irvinehackerfab/spincoater/arduino/esp32_arduino/README.md

# ESP32
This folder contains [Arduino](https://www.arduino.cc/en/software/) programs that you flash onto the ESP32.

The guide for programming the ESP32 in the Arduino IDE can be found [here](https://docs.espressif.com/projects/arduino-esp32/en/latest/index.html).
