irvinehackerfab/spincoater/arduino/esp32_arduino/pwm/README.md

# ESP32 PWM
This program uses the [ESP32Servo](https://github.com/madhephaestus/ESP32Servo) library.
