irvinehackerfab/spincoater/rust/README.md

# Rust for Spin Coater
This is the workspace for device-agnostic libraries and [Rust](https://rust-lang.org/) programs that run on the host PC.

Programs that run on the spin coater's microcontrollers can be found in the [cross](./cross) folder.

To develop these programs, either [install Rust](https://rust-lang.org/tools/install/) or use the dev environment provided by and documented in [DEVELOPMENT.md](DEVELOPMENT.md).

To build `host_tui` for Windows, [install Nix](https://nixos.org/download/) and run `nix build .#host_tui_windows`. The `.exe` will be in `./result/bin/`.
