irvinehackerfab/spincoater/data/2026-10-09-controller-comparison/CMP_05_duty_cycle.png

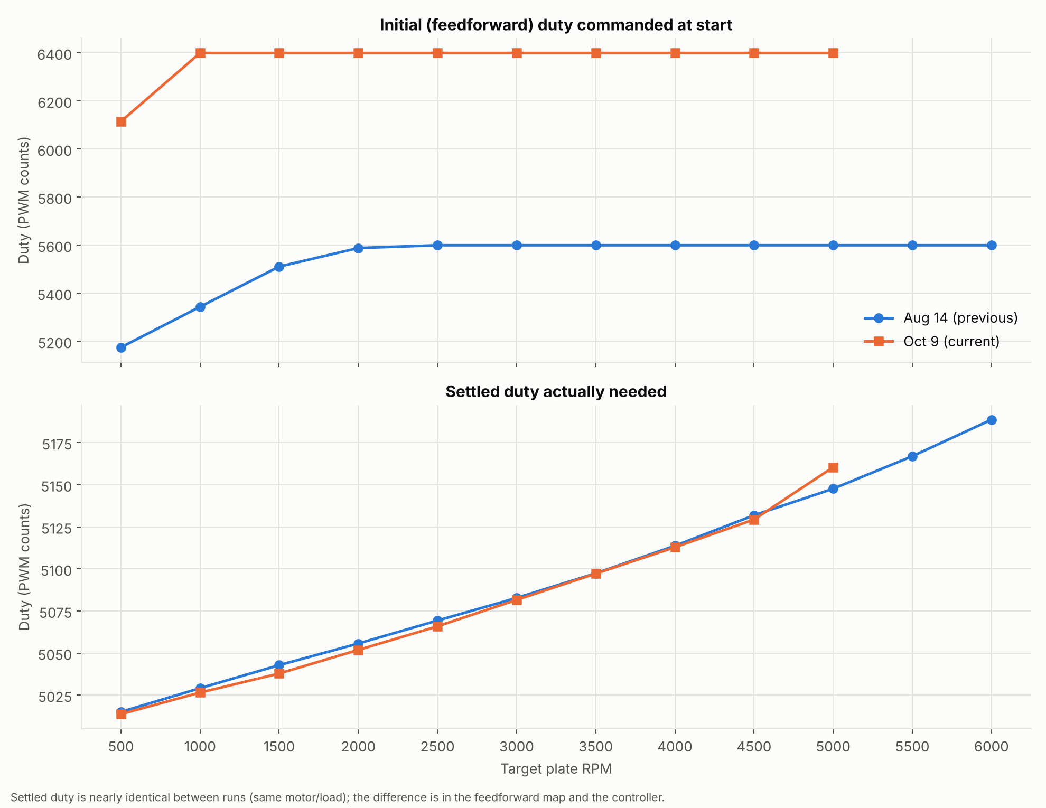
data/2026-10-09-controller-comparison/CMP_05_duty_cycle.png
