irvinehackerfab/spincoater/images/cad/v34-r1-section-closeup.png

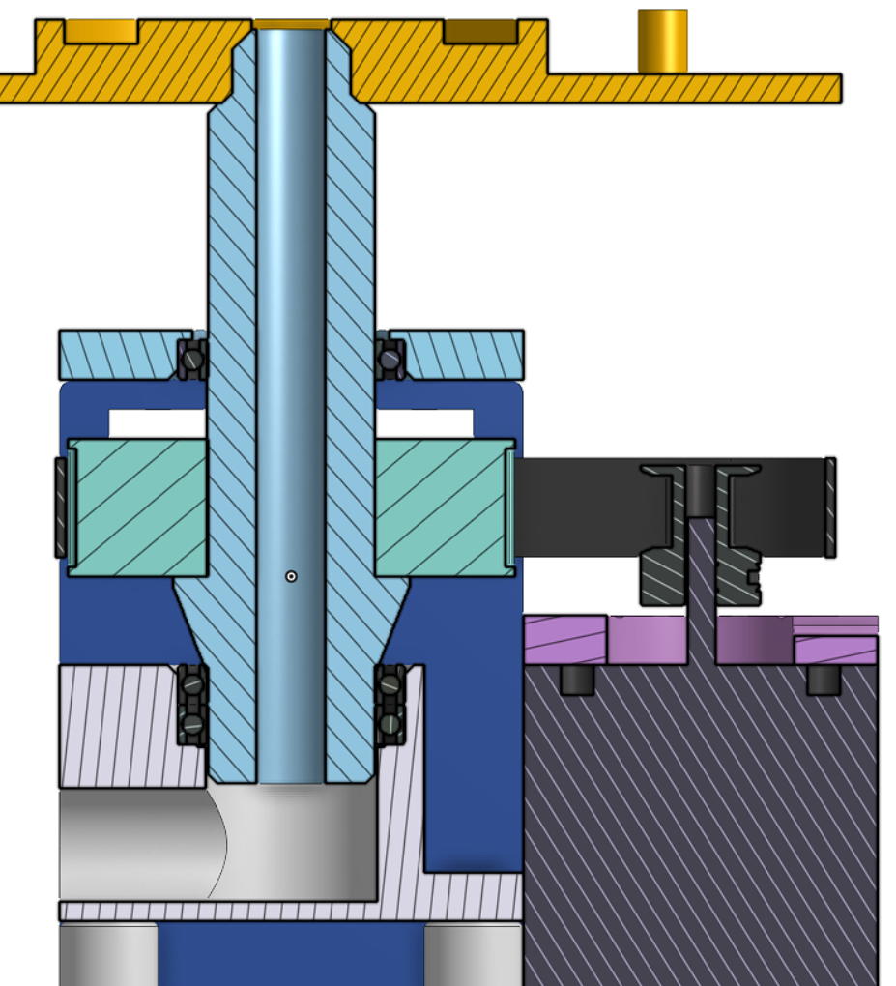
images/cad/v34-r1-section-closeup.png
