irvinehackerfab/spincoater/images/diagrams/power-board-schematic.png

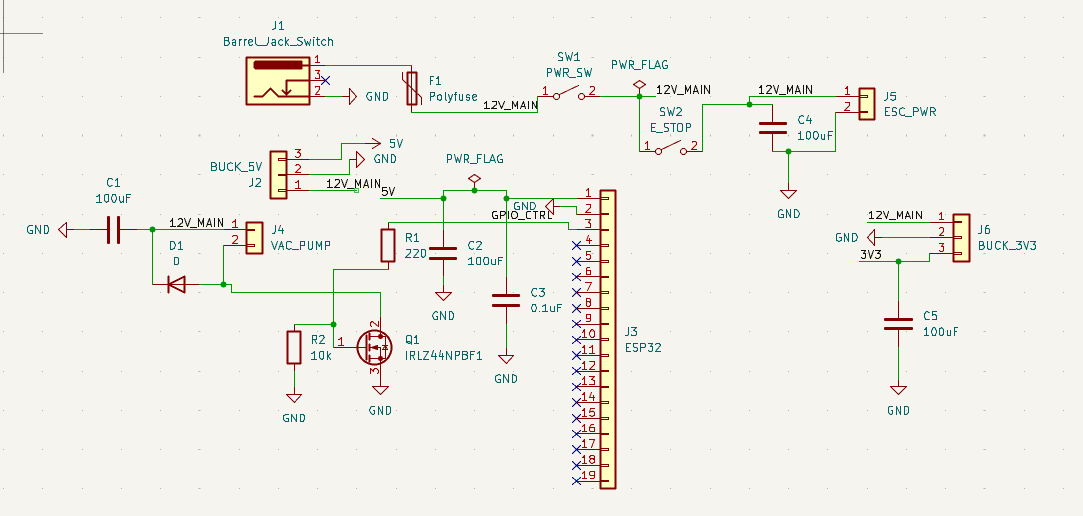
images/diagrams/power-board-schematic.png
