irvinehackerfab/spincoater/images/photos/2025-10-26-gt2-belts-and-pulley.jpg

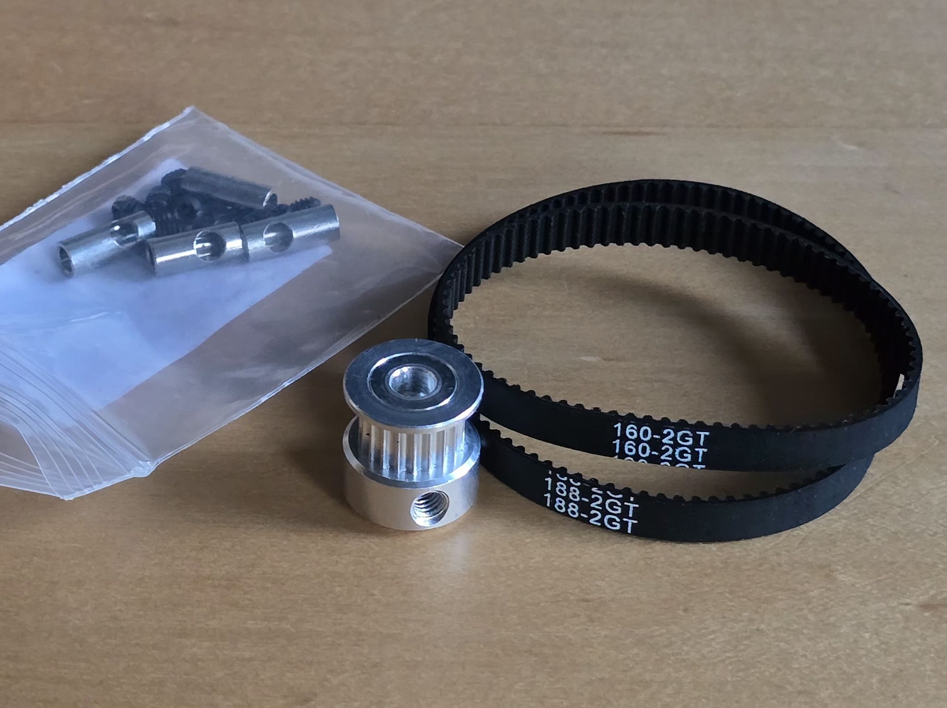
images/photos/2025-10-26-gt2-belts-and-pulley.jpg
