irvinehackerfab/spincoater/images/photos/2026-02-19-microscope-pattern-1.jpg

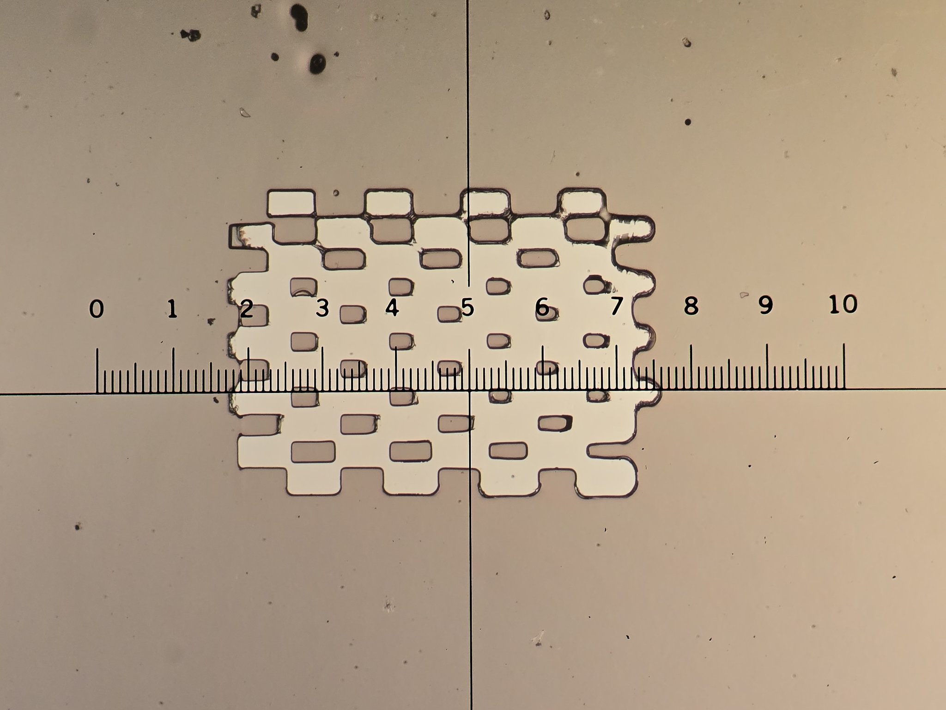
images/photos/2026-02-19-microscope-pattern-1.jpg
