irvinehackerfab/spincoater/images/photos/2026-05-07-screen-and-board-stack.jpg

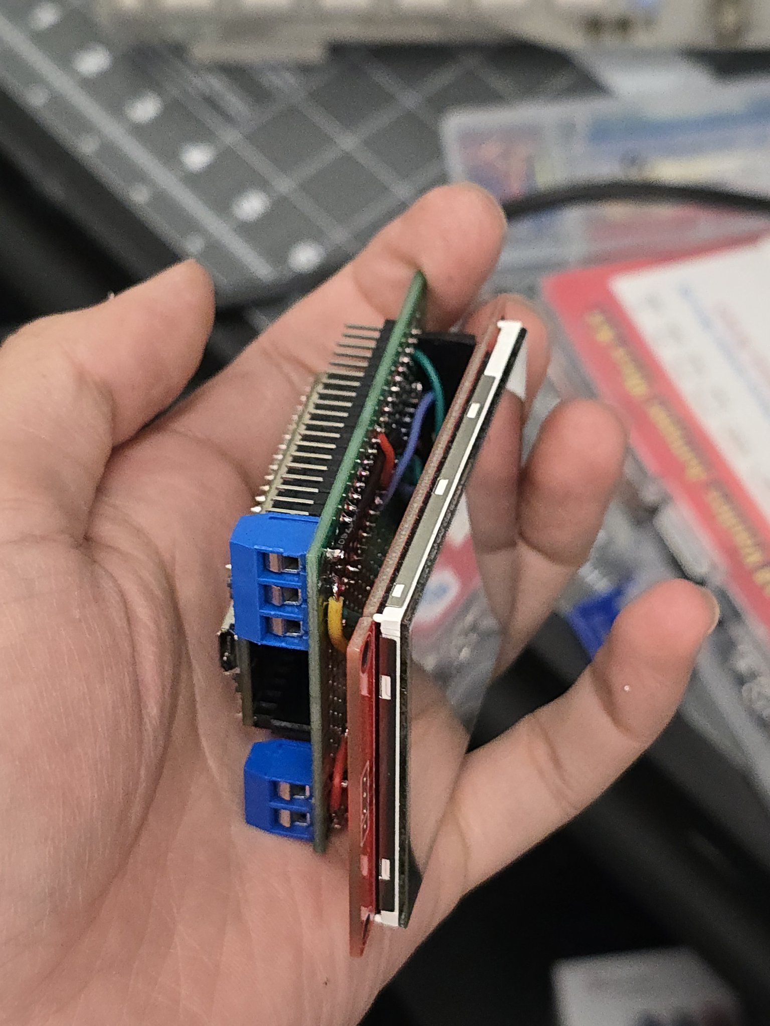
images/photos/2026-05-07-screen-and-board-stack.jpg
