irvinehackerfab/spincoater/hardware/cad/right-motor-mount-support.step

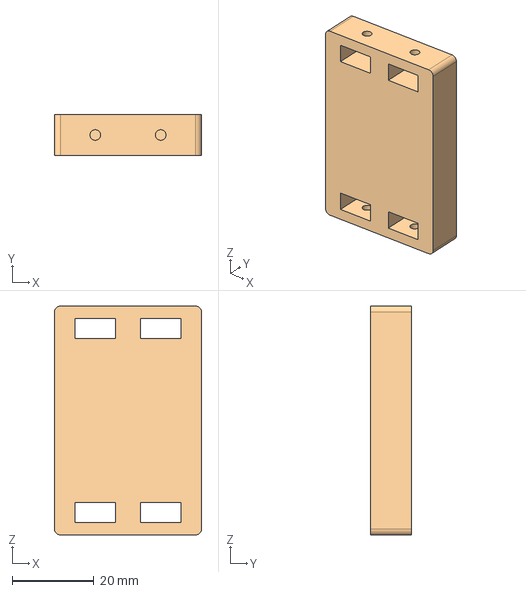
[picture p11: CAD file, 2026-10-12]
hardware/cad/right-motor-mount-support.step
36.0 x 10.0 x 56.0 mm
