irvinehackerfab/spincoater/hardware/cad/back-wall.step

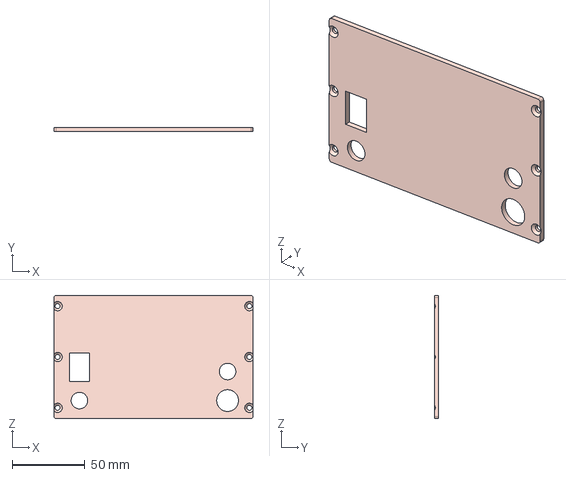
[picture p12: CAD file, 2026-10-12]
hardware/cad/back-wall.step
137.0 x 3.00 x 85.0 mm
