irvinehackerfab/spincoater/hardware/cad/right-wall.step

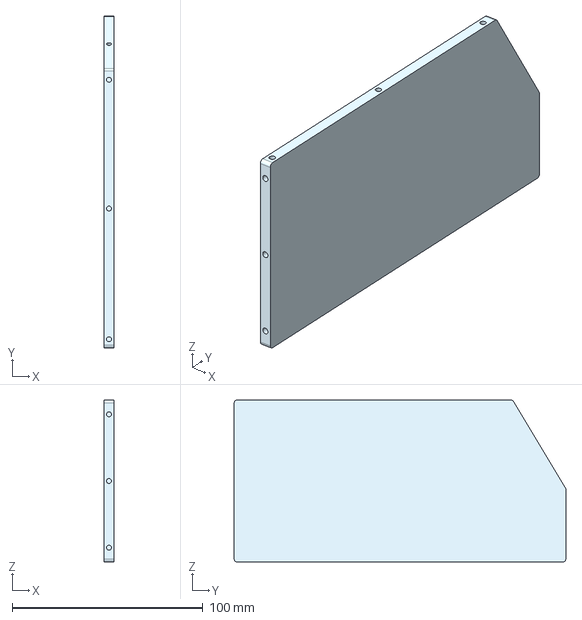
[picture p13: CAD file, 2026-10-12]
hardware/cad/right-wall.step
5.00 x 174.0 x 85.0 mm
