irvinehackerfab/spincoater/(list of files, cad)

Other CAD files:
hardware/cad/left-motor-mount-support.step
