irvinehackerfab/spincoater/data/2026-10-09-controller-comparison/CMP_02_step_response_grid.png

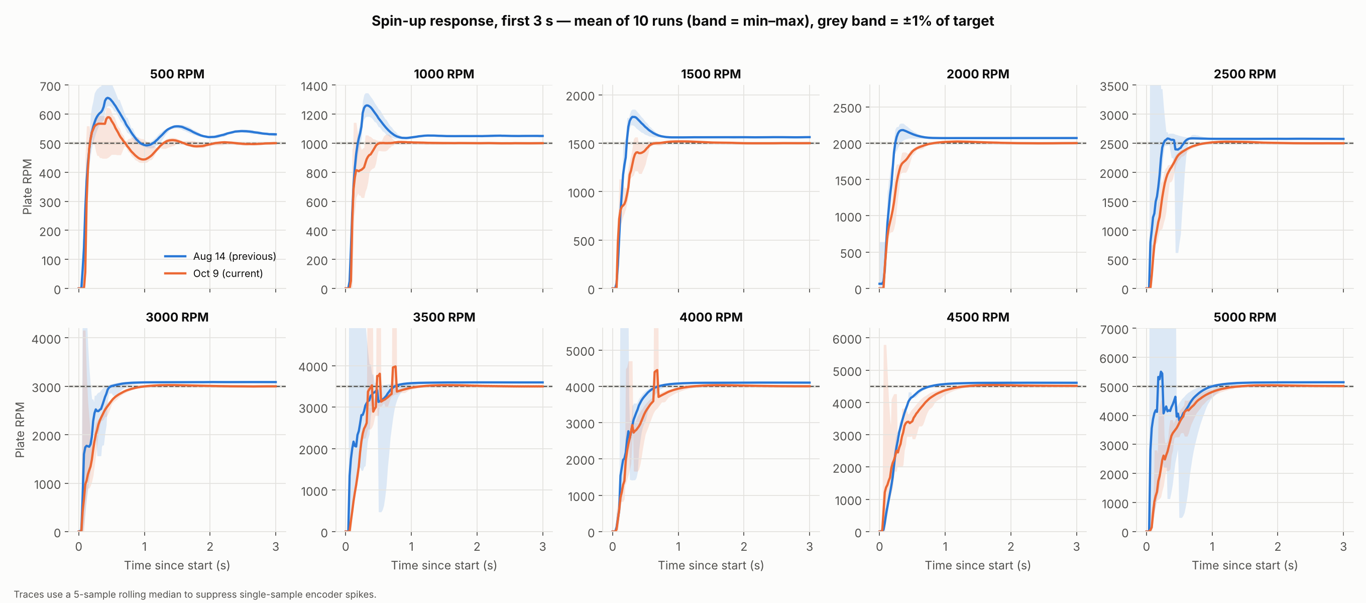
data/2026-10-09-controller-comparison/CMP_02_step_response_grid.png
