irvinehackerfab/spincoater/images/photos/2026-02-04-shaft-pulley-print.jpg

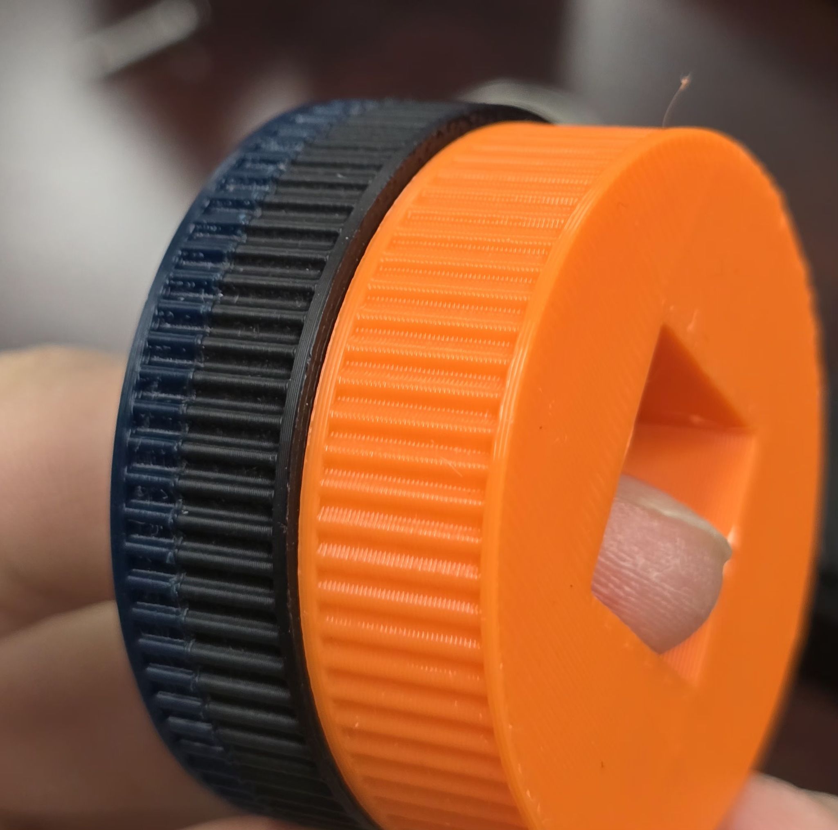
images/photos/2026-02-04-shaft-pulley-print.jpg
