irvinehackerfab/spincoater/images/photos/2026-05-08-wiring-side-panel-open.jpg

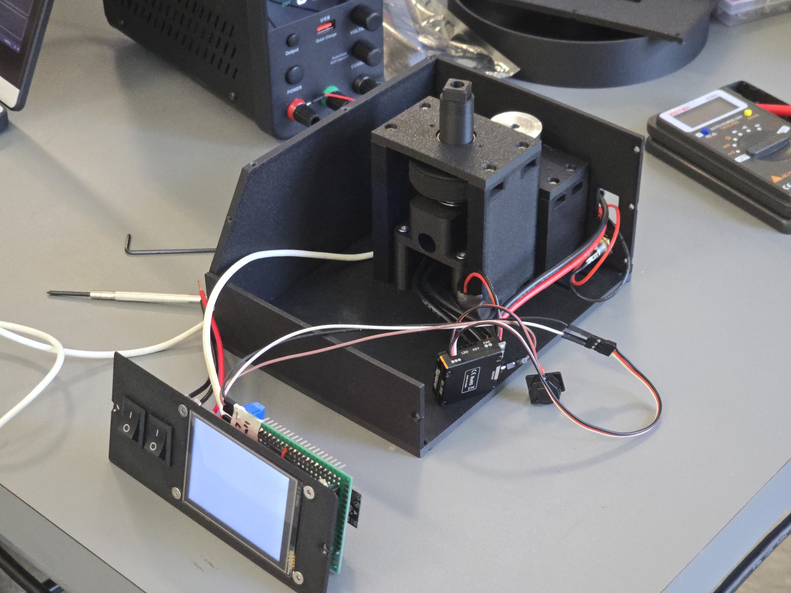
images/photos/2026-05-08-wiring-side-panel-open.jpg
