irvinehackerfab/spincoater/arduino/esp32_arduino/ESP32_spincoater_firmware/GUIv3_GSLC.h

//<File !Start!>
// FILE: [GUIv3_GSLC.h]
// Created by GUIslice Builder version: [0.17.b41]
//
// GUIslice Builder Generated GUI Framework File
//
// For the latest guides, updates and support view:
// https://github.com/ImpulseAdventure/GUIslice
//
//<File !End!>

#ifndef _GUISLICE_GEN_H
#define _GUISLICE_GEN_H

// ------------------------------------------------
// Headers to include
// ------------------------------------------------
#include "GUIslice.h"
#include "GUIslice_drv.h"

// Include any extended elements
//<Includes !Start!>
//<Includes !End!>

// ------------------------------------------------
// Headers and Defines for fonts
// Note that font files are located within the Adafruit-GFX library folder:
// ------------------------------------------------
//<Fonts !Start!>
#if !defined(DRV_DISP_TFT_ESPI)
  #error E_PROJECT_OPTIONS tab->Graphics Library should be Adafruit_GFX
#endif
#include <TFT_eSPI.h>
#include "dosis_book8pt7b.h"
//<Fonts !End!>

// ------------------------------------------------
// Defines for resources
// ------------------------------------------------
//<Resources !Start!>
//<Resources !End!>

// ------------------------------------------------
// Enumerations for pages, elements, fonts, images
// ------------------------------------------------
//<Enum !Start!>
enum {E_PG_MAIN};
enum {E_ELEM_BOX1,E_ELEM_DURATIONDOWNBTN,E_ELEM_DURATIONUPBTN
      ,E_ELEM_RPMDOWN,E_ELEM_RPMUP,E_ELEM_STARTBTN,E_ELEM_TEXT3
      ,E_ELEM_TEXT4};
// Must use separate enum for fonts with MAX_FONT at end to use gslc_FontSet.
enum {E_DOSIS_BOOK8,MAX_FONT};
//<Enum !End!>

// ------------------------------------------------
// Instantiate the GUI
// ------------------------------------------------

// ------------------------------------------------
// Define the maximum number of elements and pages
// ------------------------------------------------
//<ElementDefines !Start!>
#define MAX_PAGE                1

#define MAX_ELEM_PG_MAIN 8 // # Elems total on page
#define MAX_ELEM_PG_MAIN_RAM MAX_ELEM_PG_MAIN // # Elems in RAM
//<ElementDefines !End!>

// ------------------------------------------------
// Create element storage
// ------------------------------------------------
gslc_tsGui                      m_gui;
gslc_tsDriver                   m_drv;
gslc_tsFont                     m_asFont[MAX_FONT];
gslc_tsPage                     m_asPage[MAX_PAGE];

//<GUI_Extra_Elements !Start!>
gslc_tsElem                     m_asPage1Elem[MAX_ELEM_PG_MAIN_RAM];
gslc_tsElemRef                  m_asPage1ElemRef[MAX_ELEM_PG_MAIN];

#define MAX_STR                 100

//<GUI_Extra_Elements !End!>

// ------------------------------------------------
// Program Globals
// ------------------------------------------------

// Element References for direct access
//<Extern_References !Start!>
//<Extern_References !End!>

// Define debug message function
static int16_t DebugOut(char ch);

// ------------------------------------------------
// Callback Methods
// ------------------------------------------------
bool CbBtnCommon(void* pvGui,void *pvElemRef,gslc_teTouch eTouch,int16_t nX,int16_t nY);
bool CbCheckbox(void* pvGui, void* pvElemRef, int16_t nSelId, bool bState);
bool CbDrawScanner(void* pvGui,void* pvElemRef,gslc_teRedrawType eRedraw);
bool CbKeypad(void* pvGui, void *pvElemRef, int16_t nState, void* pvData);
bool CbListbox(void* pvGui, void* pvElemRef, int16_t nSelId);
bool CbSlidePos(void* pvGui,void* pvElemRef,int16_t nPos);
bool CbSpinner(void* pvGui, void *pvElemRef, int16_t nState, void* pvData);
bool CbTickScanner(void* pvGui,void* pvScope);

// ------------------------------------------------
// Create page elements
// ------------------------------------------------
void InitGUIslice_gen()
{
  gslc_tsElemRef* pElemRef = NULL;

  if (!gslc_Init(&m_gui,&m_drv,m_asPage,MAX_PAGE,m_asFont,MAX_FONT)) { return; }

  // ------------------------------------------------
  // Load Fonts
  // ------------------------------------------------
//<Load_Fonts !Start!>
    if (!gslc_FontSet(&m_gui,E_DOSIS_BOOK8,GSLC_FONTREF_PTR,&dosis_book8pt7b,1)) { return; }
//<Load_Fonts !End!>

//<InitGUI !Start!>
  gslc_PageAdd(&m_gui,E_PG_MAIN,m_asPage1Elem,MAX_ELEM_PG_MAIN_RAM,m_asPage1ElemRef,MAX_ELEM_PG_MAIN);

  // NOTE: The current page defaults to the first page added. Here we explicitly
  //       ensure that the main page is the correct page no matter the add order.
  gslc_SetPageCur(&m_gui,E_PG_MAIN);
  
  // Set Background to a flat color
  gslc_SetBkgndColor(&m_gui,GSLC_COL_BLACK);

  // -----------------------------------
  // PAGE: E_PG_MAIN
  
  
  // create E_ELEM_STARTBTN button with text label
  pElemRef = gslc_ElemCreateBtnTxt(&m_gui,E_ELEM_STARTBTN,E_PG_MAIN,
    (gslc_tsRect){10,10,100,100},(char*)"START",0,E_DOSIS_BOOK8,&CbBtnCommon);
  gslc_ElemSetTxtCol(&m_gui,pElemRef,GSLC_COL_BLACK);
  gslc_ElemSetCol(&m_gui,pElemRef,((gslc_tsColor){0,255,128}),((gslc_tsColor){0,255,128}),GSLC_COL_GREEN);
  gslc_ElemSetRoundEn(&m_gui, pElemRef, true);
  
  // create E_ELEM_RPMUP button with text label
  pElemRef = gslc_ElemCreateBtnTxt(&m_gui,E_ELEM_RPMUP,E_PG_MAIN,
    (gslc_tsRect){10,130,100,45},(char*)"RPM UP",0,E_DOSIS_BOOK8,&CbBtnCommon);
  gslc_ElemSetTxtCol(&m_gui,pElemRef,GSLC_COL_BLACK);
  gslc_ElemSetCol(&m_gui,pElemRef,GSLC_COL_YELLOW,GSLC_COL_YELLOW,GSLC_COL_ORANGE);
  gslc_ElemSetRoundEn(&m_gui, pElemRef, true);
  
  // create E_ELEM_DURATIONUPBTN button with text label
  pElemRef = gslc_ElemCreateBtnTxt(&m_gui,E_ELEM_DURATIONUPBTN,E_PG_MAIN,
    (gslc_tsRect){130,140,180,40},(char*)"DURATION UP",0,E_DOSIS_BOOK8,&CbBtnCommon);
  gslc_ElemSetRoundEn(&m_gui, pElemRef, true);
  
  // create E_ELEM_DURATIONDOWNBTN button with text label
  pElemRef = gslc_ElemCreateBtnTxt(&m_gui,E_ELEM_DURATIONDOWNBTN,E_PG_MAIN,
    (gslc_tsRect){130,190,180,40},(char*)"DURATION DOWN",0,E_DOSIS_BOOK8,&CbBtnCommon);
  gslc_ElemSetRoundEn(&m_gui, pElemRef, true);
   
  // Create E_ELEM_BOX1 box
  pElemRef = gslc_ElemCreateBox(&m_gui,E_ELEM_BOX1,E_PG_MAIN,(gslc_tsRect){130,10,180,120});
  gslc_ElemSetCol(&m_gui,pElemRef,GSLC_COL_GRAY,((gslc_tsColor){38,58,151}),((gslc_tsColor){38,58,151}));
  
  // Create E_ELEM_TEXT3 text label
  pElemRef = gslc_ElemCreateTxt(&m_gui,E_ELEM_TEXT3,E_PG_MAIN,(gslc_tsRect){159,28,120,12},
    (char*)"IRVINE HACKER FAB",0,E_DOSIS_BOOK8);
  gslc_ElemSetCol(&m_gui,pElemRef,GSLC_COL_GRAY,((gslc_tsColor){38,58,151}),((gslc_tsColor){38,58,151}));
  
  // Create E_ELEM_TEXT4 text label
  pElemRef = gslc_ElemCreateTxt(&m_gui,E_ELEM_TEXT4,E_PG_MAIN,(gslc_tsRect){170,52,99,12},
    (char*)"SPIN COATER V3",0,E_DOSIS_BOOK8);
  gslc_ElemSetCol(&m_gui,pElemRef,GSLC_COL_GRAY,((gslc_tsColor){38,58,151}),((gslc_tsColor){38,58,151}));
  
  // create E_ELEM_RPMDOWN button with text label
  pElemRef = gslc_ElemCreateBtnTxt(&m_gui,E_ELEM_RPMDOWN,E_PG_MAIN,
    (gslc_tsRect){10,185,100,45},(char*)"RPM DOWN",0,E_DOSIS_BOOK8,&CbBtnCommon);
  gslc_ElemSetTxtCol(&m_gui,pElemRef,GSLC_COL_BLACK);
  gslc_ElemSetCol(&m_gui,pElemRef,GSLC_COL_YELLOW,GSLC_COL_YELLOW,GSLC_COL_ORANGE);
  gslc_ElemSetRoundEn(&m_gui, pElemRef, true);
//<InitGUI !End!>

//<Startup !Start!>
//<Startup !End!>

}

#endif // end _GUISLICE_GEN_H
