irvinehackerfab/spincoater/rust/cross/esp32/src/gpio/mod.rs

//! This module contains all GPIO functionality.
//!
//! See [Espressif's documentation](https://docs.espressif.com/projects/esp-idf/en/stable/esp32/api-reference/peripherals/gpio.html)
//! for more information on GPIO.

pub mod display;
pub mod encoder;
pub mod pwm;
