irvinehackerfab/spincoater/arduino/esp32_arduino/ESP32_spincoater_firmware/GUIv3.ino

//<App !Start!>
// FILE: [GUIv3.ino]
// Created by GUIslice Builder version: [0.17.b41]
//
// GUIslice Builder Generated File
//
// For the latest guides, updates and support view:
// https://github.com/ImpulseAdventure/GUIslice
//
//<App !End!>

// ------------------------------------------------
// Headers to include
// ------------------------------------------------
#include "GUIv3_GSLC.h"


// ------------------------------------------------
// Program Globals
// ------------------------------------------------

// Save some element references for direct access
//<Save_References !Start!>
//<Save_References !End!>

// Define debug message function
static int16_t DebugOut(char ch) { if (ch == (char)'\n') Serial.println(""); else Serial.write(ch); return 0; }

// ------------------------------------------------
// Callback Methods
// ------------------------------------------------
// Common Button callback
bool CbBtnCommon(void* pvGui,void *pvElemRef,gslc_teTouch eTouch,int16_t nX,int16_t nY)
{
  // Typecast the parameters to match the GUI and element types
  gslc_tsGui*     pGui     = (gslc_tsGui*)(pvGui);
  gslc_tsElemRef* pElemRef = (gslc_tsElemRef*)(pvElemRef);
  gslc_tsElem*    pElem    = gslc_GetElemFromRef(pGui,pElemRef);

  if ( eTouch == GSLC_TOUCH_UP_IN ) {
    // From the element's ID we can determine which button was pressed.
    switch (pElem->nId) {
//<Button Enums !Start!>
      case E_ELEM_STARTBTN:
        Serial.println("Start Button Pressed");
        break;
      case E_ELEM_RPMUP:
        Serial.println("RPMUP Button Pressed");
        break;
      case E_ELEM_DURATIONUPBTN:
        Serial.println("DURATIONUP Button Pressed");
        break;
      case E_ELEM_DURATIONDOWNBTN:
       Serial.println("DURATIONDOWN Button Pressed");
        break;
      case E_ELEM_RPMDOWN:
         Serial.println("RPMDOWN Button Pressed");
        break;

//<Button Enums !End!>
      default:
        break;
    }
  }
  return true;
}
//<Checkbox Callback !Start!>
//<Checkbox Callback !End!>
//<Keypad Callback !Start!>
//<Keypad Callback !End!>
//<Spinner Callback !Start!>
//<Spinner Callback !End!>
//<Listbox Callback !Start!>
//<Listbox Callback !End!>
//<Draw Callback !Start!>
//<Draw Callback !End!>
//<Slider Callback !Start!>
//<Slider Callback !End!>
//<Tick Callback !Start!>
//<Tick Callback !End!>
