irvinehackerfab/spincoater/(commit log)

2025-11-18 Add ESP32 spin coater firmware
    update pins
2026-01-28 Added ESP32 PWM program
2026-01-28 Added pin link
2026-01-29 Added ESP32 Arduino PWM
2026-01-29 Match timer resolution to Rust program
2026-01-29 Add exact duty cycle writes to Arduino program
2026-01-30 Resorted repo, added wifi-controlled PWM to the ESP32
    (Still need to create a host PC program)
2026-01-30 Removed COBS encoding from serialization
    TCP has error correction, so as long as we write tests to guarantee that
    deserializing a partial message results in
    Error::DeserializeUnexpectedEnd we will be fine without COBS.
    [lib.rs, mod.rs]
2026-02-01 Finished the wireless interface between the ESP32 and PC
    For now, the PC user interface just sets duty cycle to STOP or MAX.
2026-02-02 Moved wifi methods into a reusable library and added back basic PWM program
2026-02-03 Move .ino programs into sketch folders
    Required by Arduino IDE
2026-02-04 Fixed some bugs with rust PWM programs
    [ESP32_spincoater_firmware.ino, main.rs, mod.rs]
2026-02-04 Fix bytes being discarded past COBS sentinel value
    [mod.rs]
2026-02-04 Fix only one message being deserialized if two messages are read at once
    [mod.rs]
2026-02-05 Added lints and fixed linted code
    [lib.rs, main.rs, mod.rs]
2026-02-05 Fixed some more linted code
    [main.rs]
2026-02-07 cleanup for comments
    Updated comments for clarity, modified debounce timing in ISR, and adjusted motor pin configuration for stability during boot.
    [ESP32_spincoater_firmware.ino]
2026-02-07 Added a persistent log file for messages
    - Also removed writing to the log when sending messages b/c it didn't
    guarantee anything about the messages being sent.
    - Also fixed an off-by-one indexing error
    [main.rs, mod.rs]
2026-02-11 Got ESP32 wifi working
    - Fixed rustanalyzer errors by disabling tests (we'll need to switch
    from espflash to probe-rs if we want to use embedded-test)
    - Added TCP keep-alive to prevent TUI from disconnecting after
    inactivity
    - Fixed TUI wiping the terminal before connecting to MCU
    [main.rs, mod.rs]
2026-02-12 Replace IR with hall effect sensor
    - Remove IR debounce because we are now using hall effect and we want to
    see if it is accurate without debounce.
    - Change the interrupt to activate on rising instead of falling because
    Daniel explained the hall effect sensor in terms of high output.
    - Make some variable names more descriptive
    - Add more comments to help guide readers of the code
    [ESP32_spincoater_firmware.ino]
2026-02-15 Improve ESP32 PWM output
    - Rename `wifi_pwm` program to `spincoater` because I will be adding
    more features than Wifi and PWM to it
    - Increase PWM resolution by maximizing the range of duty cycle values
    we can output (thanks for the inspiration Daniel!)
    - Move PWM constants into the ESP32 library
2026-02-15 Started working on multcore execution
    - Also changed the PWM output pins to match the ones used by the esp32
    arduino program
2026-02-16 Finished multicore boilerplate
    - Started working on hall effect motor readings
2026-02-16 Added rpm reading to rust program
    - Fixed esp32 arduino comment
    - Moved message handling to first core because it waits for wifi
    messages regardless of the core. The second core now only handles GPIO
    interrupts.
    - Replaced zerocopy channel with channel because zerocopy is less memory
    efficient for messages as small as ours.
    [ESP32_spincoater_firmware.ino, lib.rs, main.rs, mod.rs]
2026-02-16 Fix duty cycle names and off-by-one errors
    "There are 2 hard problems in computer science: cache invalidation,
    naming things, and off-by-1 errors."
    - Leon Bambrick
    [lib.rs, main.rs, mod.rs]
2026-02-17 Remove unused include
    (I forgot to remove it after adding the hall effect sensor)
2026-02-17 Pin toolchain channel
    - If you'd like to use nightly for something, please notify all
    spincoater programmers in the global Hacker Fab discord.
2026-02-21 WIP implement display
    - Had to change the encoder pin because the display needs it
    - Make wifi buffers ConstStaticCell
2026-02-23 Replace mention of IR with HE
    [ESP32_spincoater_firmware.ino]
2026-02-24 Create PCB
2026-02-25 Disable framebuffer feature
    It was causing a panic because the heap wasn't large enough. If the
    resulting screen tearing is too noticeable, we can add it back and
    increase the heap size.
    - Also update dependencies
2026-02-28 Fix borrow types and reduce stack usage
    - This stack optimization is only applicable right now because messages
    are smaller than 32 bits.
    [lib.rs, mod.rs]
2026-02-28 Fix stack and heap overflows
    [lib.rs, main.rs]
2026-02-28 Increase display font size
    - Switch to a font with less characters to speed up flash times
    - Remove unused import
2026-03-01 Replaced "channel full" print with a boolean on the terminal
    This should make it less likely for us to miss the "channel full"
    warning.
    - Separate channel functionality into channel modules
    - Move ui module from directory to file (I don't plan on making
    submodules for it)
    - Fix doc links
    - Update dependencies
    [lib.rs, main.rs, mod.rs, ui.rs]
2026-03-01 Display information on the terminal
    Unfortunately, constructing the terminal UI in a way that minimizes
    string reallocations also results in high stack usage. I inlined the
    paragraph construction to try and deal with this.
    - Remove defmt. We will likely add it back later when we switch from
    espflash to probe-rs.
    - Change spincoater main to construct more values in-place
    - Separate access point state from socket state
2026-03-02 Fix unnecessary mutable borrow
    [mod.rs]
2026-03-02 Update microbit dependencies
    - Fix microbit program to work with dependency changes
    [main.rs]
2026-03-04 WIP trying to get valid RPM readings
    We get RPM in the hundreds of thousands, which is definitely wrong.
    [ESP32_spincoater_firmware.ino]
2026-03-04 Attempt to fix program freeze
    Neither the socket nor the access point reported anything when the host
    TUI quit. Hopefully this fixes that.
    - Improve MCU TUI output
    - Allow wifi controller to handle any useful event
    [lib.rs, main.rs, mod.rs, ui.rs]
2026-03-04 Switch back to millis and add small delay between rpm readings
2026-03-04 Fix crossterm event stream task silently failing
    This is most likely what caused the freezes.
    [mod.rs]
2026-03-05 Fix silent failure in host TUI upon socket close
    - Moved host TUI dev socket creation to its own feature
    - Add note in host TUI log whenever a dev socket message is received
    - Make MCU IP config const
    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
    [main.rs, mod.rs]
2026-03-05 Update pin configuration
    We need to keep some pins free in case we get an ESP-PROG-2.
2026-03-05 Finally fix random socket freezes
    It turns out smoltcp just randomly refuses to give you access to all the
    bytes of a message, so we need another buffer to store the bytes.
    This solution uses heap allocation because BytesMut makes it a lot
    easier to keep track of written bytes. This means it may silently
    reallocate, but because we're tracking the heap usage on the terminal,
    we'll be able to detect if it uses too much memory.
    [main.rs, mod.rs]
2026-03-05 Fix incorrect clearing of buffer
    - Also disable PWM if the socket disconnects
    [mod.rs]
2026-03-09 Fix duty cycle usage in pwm program
    [main.rs]
2026-03-11 Allow user to choose duty cycle in host TUI
    - Guarantee valid duty cycles in the DutyCycle struct
    - Add tui input dependency
    - Pass the Ratatui frame to App so it can set the cursor
2026-03-26 Add clarification for environment variable compile errors
    Using option_env is a bad idea here because if you forget to set the
    environment variable, you’ll have to reflash, which wastes a lot of
    time.
    [main.rs]
2026-04-02 Uploading current ESP32 development code for V3
2026-04-08 Updated PID & MicroPython Pin Names
2026-04-08 Remove microbit program
    I don't have the time to maintain it anymore, and it doesn't have
    capabilities we need.
    [main.rs]
2026-04-09 Implement CSV loading, WIP motion profiles
    Now we just need feedforward and PID gains to calculate the duty value.
    We might need to store previous rpms to calculate the derivative, and we
    might want a moving average, but we'll get to that later.
    [default.csv]
2026-04-09 Implemented motion profile feedforward
    This currently only does feedforward, not feedback.
    [default.csv]
2026-04-09 Merged control loop and rpm task
    It doesn't need to be in a separate task.
    [mod.rs, ui.rs]
2026-04-10 Tested and fixed bugs
    [lib.rs, main.rs, mod.rs, ui.rs]
2026-04-10 Fixed more bugs
    - Added note about freezing
    - Add motion profile sleep that I forgot to add back
    - Fixed typo that prevented host PC connection from being detected
    - Added more print statements
    [lib.rs, mod.rs]
2026-04-10 Disable motor after motion profile finishes
2026-04-13 WIP replace custom wire format with postcard-rpc
    This will remove the boilerplate of manually sending and receiving
    packets. It will also make it easy to use UART to communicate instead of
    wifi (we can use postcard-rpc's topics to replace the lost printing
    functionality.)
    [icd.rs, lib.rs, motion_profile.rs, pwm.rs]
2026-04-13 WIP replace wifi with UART
    [lib.rs, main.rs, mod.rs, ui.rs]
2026-04-14 WIP Replace wifi with UART
    I made the server, but I still have to use its senders and use it for
    defmt.
    [lib.rs, main.rs, mod.rs]
2026-04-17 Fix incorrect pin in README
2026-04-17 Make PWM the same as branch v3
2026-04-17 WIP Replace wifi with UART
    - Add note about pwm program
    - Switch command channel to zerocopy to reduce copies
    - Moved motion profile runner to library
    - Added communication between runner and server
    [lib.rs, main.rs, mod.rs, ui.rs]
2026-04-17 WIP Replace wifi with UART
    - Output server error to display
    [main.rs, mod.rs, ui.rs]
2026-04-17 WIP Replace wifi with UART
    - Finish firmware side
    [main.rs, mod.rs, motion_profile.rs]
2026-04-18 Get UART communication somewhat working
    It's unreliable, and randomly freezes the TUI.
2026-04-18 Implemented UART communication
    - Added vacuum pump control on pin 17
2026-04-22 Refactor motion profile sleep and make it immune to overruns and oversleep
    I tested the changes and didn't see any noticable time accuracy
    improvements, but it's good to have this in case our code gets slower
    later.
    [mod.rs]
2026-04-23 Make display horizontal for new enclosure
2026-04-24 Replace hard brake with neutral for stop duty
    [pwm.rs]
2026-04-30 Increase buffer sizes to try and fix freezes
    - Fix incorrect pin comment
    [lib.rs, main.rs, mod.rs]
2026-05-01 Increase rpm values in motion profile
    [default.csv]
2026-05-01 Fixed encoder freezing program...
    But now the program freezes when the motion profile finishes.
    [lib.rs, main.rs, mod.rs]
2026-05-01 Fixed the random program crashing
    It was due to underflow when subtracting setpoint RPM values. I must
    have used fold wrong somehow.
    - Updated profiles to most recent esp-generate template
    - Moved encoder back into the second core, this time using async instead
    of interrupts
    - Removed all usages of log_fmt because it isn't actually implemented.
    This took me hours to find out.
    - Remove duplicate THROTTLE_CURVE rpm to prevent division by zero
    - Use checked operations for more math
    [default.csv]
2026-05-01 Moved UART to other pins
    This means we can flash and monitor over USB, while simultaneously
    commmunicating over UART with the ESP-Prog-2.
2026-05-01 Add setpoint time verification
    - Fix division by zero
    - Removed old UART message
    [main.rs, mod.rs, motion_profile.rs]
2026-05-02 Remove wirespawn
    Wirespawn is for handling async messages without awaiting, which we
    don't need right now.
2026-05-02 Update Cargo.lock...
    - Fix compile errors from missing tilde
    - Add notes about unusable pins
    - Add stack smashing protection
    [main.rs]
2026-05-02 Begin work on reproducible dev environment for ESP32 Rust development
2026-05-04 Add back old interrupt handler, but with a fix
    This interrupt handler guarantees that we won't miss rising edges
    because it never stops listening. I think I just needed to clear the
    interrupt for it to work correctly.
    [main.rs, mod.rs]
2026-05-04 Add comments to interrupt handler
2026-05-06 Tested ESC and fixed bugs:
    - Changed sc_messages dependency from git to path so we don't need to
    push to get changes
    - Fixed incorrect pins in README
    - Removed display usage. It's not useful for this program since we
    communicate over UART. This allows us to use the ESP-Prog-2.
    - Changed plate RPM to motor RPM everywhere to allow for less precision
    loss from integer division
    - Increased loop period so that more motor revolutions could accumulate
    per loop. They went from ~4 to ~60.
    - Log an empty state when the motion profile finishes
    - Use microseconds instead of milliseconds for greater precision
    [default.csv]
2026-05-06 Filter out non-ESP32 serial ports in prompt
2026-05-07 Pin rust versions and add comments to DEVELOPMENT guides
    Pinning rust in this way is helpful for those not using the `rust` dev
    shell, and is necessary for the `mc_esp32` dev shell because we
    currently have no other way of specifying a version of Espressif's
    toolchain.
2026-05-07 Add plate RPM logging
2026-05-07 Add a cargo feature to allow for either DevKitC USB or ESP-Prog-2 USB communication
    - Added a list sort to work around postcard_rpc sending requests in the
    wrong order
    [main.rs, mod.rs, motion_profile.rs]
2026-05-08 Update motor-to-plate RPM conversion...
    - List all current pins, and all pins we may use in the future or in
    other programs.
    [default.csv]
2026-05-08 Sort pin layout and mark pins with bold
2026-05-08 Disable motion profile when host TUI closes cleanly
    I do not currently know of a way to detect when the host PC disconnects
    without any notice.
    [default.csv]
2026-05-08 Fix LED backlight enable in README
2026-05-08 Fix pin descriptions in README
    This doesn't actually change any of the pins we need to solder.
    [main.rs]
2026-05-08 Improvements to documentation...
    - Renamed mc_esp32 to esp32 because it does more than motor control. In
    reality, we are offloading the actual motor control to the ESC.
    - Removed reference to nonexistent `editor_configurations` folder
    - Annotated all directories in "README"s
    - Make host_tui exit if it does not find any devices
    - Create pin usage checker binary that employs the borrow checker to
    prevent pin conflicts
    [lib.rs, main.rs, mod.rs, pwm.rs, ui.rs]
2026-05-08 Replace critical section mutex with non reentrant mutex
    esp_sync provides a mutex that doesn't require a critical section.
    If we need critical sections, we can add them back later.
    [main.rs, mod.rs]
2026-05-08 Make a new CSV file for every motion profile run...
    - Prevent errors in the main loop from bypsasing the disconnect
    notification
    [mod.rs]
2026-05-09 Change rpm calculation to a moving average
    The resulting RPM values are much higher accuracy. RPM calculation is
    done during the encoder interrupt on the second core, so it doesn't
    block the motion profile runner.
    [default.csv]
2026-05-09 Got spincoater motor control to a very good state
    - Used multiple passes of linear regression to improve feedforward
    - Added linear regression program for others to reuse
    - Set the PWM to a sufficiently high value at the start of the motion
    profile to overcome static friction
    - Fix log files being .txt instead of .csv
    - Log RPM error
    - Moved host TUI functionality into library crate for use in linear
    regression program
    [default.csv]
2026-05-10 Create and use XPT2046 touchscreen driver
    Untested, but based on an existing crate:
    https://github.com/VersBinarii/xpt2046/tree/master
2026-05-10 Remove unnecessary generic, switch to constant touch updates for now
2026-05-11 Further touchscreen work...
    I have the touchscreen working reliably and I have the buttons on the
    display, but I still need to make the touchscreen task send events to
    the terminal.
2026-05-14 Various improvements...
    - Update comments
    - Increase display buffer size
    - Replace vague XPT driver method name "init"
    - Print touch SPI errors
    - Replace critical section mutexes with more efficient mutex from
    esp-hal.
    - Wrap signal in a static cell to gain Sync
    [lib.rs, main.rs, mod.rs, motion_profile.rs]
2026-05-14 Fix rust-analyzer in esp32 dev environment
2026-05-15 WIP fixes for spincoater
    - Disable PWM at the end of the motion profile
    - Add RPM buffer
    [main.rs, mod.rs, ui.rs]
2026-05-15 Fix too many updates to display and inaccurate touch inputs
    [encoder.rs, mod.rs, motion_profile.rs]
2026-05-15 Fix rpm reading freezing due to the filter being too strict
    [default.csv]
2026-05-15 Fixes to spincoater program
    - Added fixes from spincoater PC program to spincoater program
    - Reduced moving average window to prevent inaccurate RPM values on
    display
    [mod.rs, ui.rs]
2026-05-15 Switch SPI to DMA
2026-05-17 Improvements to XPT driver
    - Require the user to provide the buffer. This means the user can place
    the buffer in static memory to save stack space.
    - Deduplicate macros
    - Lerp the averages instead of each value
2026-05-21 Hand-tune feedforward for motor with plate attached
    - Fix startup oscillations by increasing kickstart time
    - P needs to be increased now that the moment of inertia is higher
    [mod.rs, pwm.rs]
2026-05-22 Many fixes for spincoater now that the new power board is in...
    Important note: Right now, the spincoater only works reliably when the
    ESP32 is powered through USB. This is almost certainly a hardware issue.
    - Keep target RPM and time on the display alongside current RPM and time
    - Raise the error tolerance for rpm readings to account for more
    spurious interrupts with the new power board
    - Re-tune feedforward and P gains for spincoater now that the plate is
    attached
    - Cut the maximum allowed duty cycle in half to avoid tripping
    overcurrent protection on the new power supply
    [constant.csv, increasing.csv]
2026-05-23 Encoder improvements
    - Rename one the calculate_rpm functions to make its purpose more clear
    - Only listen to interrupts when the runner is running
    - Initialize encoder mutex on the first core to avoid race condition
    when runner starts
    [encoder.rs, main.rs, mod.rs, motion_profile.rs]
2026-05-29 Attempt to workaround ESC hardware issues
    [main.rs, mod.rs, motion_profile.rs]
2026-05-29 Switch from pull up to pull down
    This helps reduce jittery 0V logic somehow? Anyways spincoater works
    with power board now
    [main.rs, mod.rs, motion_profile.rs]
2026-05-31 Don't reset the target rpm and time upon finish
    [mod.rs]
2026-06-17 Update flakes and dependencies and fix rust-analyzer in esp32 crate
2026-06-18 Replace all truncation with explicit clamping
    I forgot that truncation is a wrapping conversion, not a saturating
    conversion. This might fix rpm spikes at the start of a spin.
    - Eliminate hidden panic in calculate_average_rpm
    [encoder.rs, lib.rs, mod.rs, pid.rs, pwm.rs]
2026-06-29 Replace parameter clamp with result clamp
    This makes the end behavior more clear. The edge case behavior is not
    changed.
    [pid.rs]
2026-07-01 Many changes...
    - Add new touchscreen library. This significantly improves touchscreen
    accuracy.
    - Lower DMA buffer size to fix "MaxDmaTransferSizeExceeded" error
    - Add type alias for postcard server sender
    - Remove touch topics from ICD (we can just print data for now)
    - Add touchscreen test and calibration programs
    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
    [event.rs, icd.rs, lib.rs, main.rs, mod.rs, motion_profile.rs, pid.rs]
2026-07-01 Add clarification to press filter comment
2026-07-02 Many changes...
    - Lower SPI clock rate to meet XPT2046 requirement
    - Turn SPI settings into constants
    - Fix the spincoater display not being fully black
    - Recalibrate touchscreen
    - Make touchscreen filter into a constant
    - Explicitly set X plate resistance
    - Remove rpm filter because we don't need it anymore!
    [encoder.rs, main.rs, mod.rs]
2026-07-03 Update XPT driver
2026-07-05 WIP replace postcard_rpc with custom server
    Doing this will unblock us from updating esp-hal.
    Still needs to be tested.
    - Replace tokio with multithreaded code in host_tui
    - Fix duty cycle truncating instead of clamping
    [event.rs, icd.rs, lib.rs, main.rs, mod.rs, motion_profile.rs, pwm.rs, uart.rs]
2026-07-06 Replace postcard-rpc with custom server
    Now we can update esp-hal.
    [event.rs, icd.rs, lib.rs, main.rs, mod.rs, motion_profile.rs, uart.rs]
2026-07-08 Update esp-hal to 1.1.0
    The `spincoater` program currently does not respond to touches.
    It gets stuck waiting for PEN_IRQ to go low.
    This doesn't happen in the other touch programs, which makes me think this is a hardware issue.
    I need an oscilloscope to diagnose this further.
    [main.rs, mod.rs]
2026-07-11 Add single RPM support to `spincoater_with_pc` and other improvements
    - Add rounding to plate to/from motor RPM conversions
    - Remove dev socket feature. We can't easily make host_tui generic over
    IO because `SerialPort` allows IO from immutable borrows while
    `std::io` doesn't.
    - Make it more clear which commands will work while the MCU is running.
    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
    [encoder.rs, lib.rs, mod.rs, motion_profile.rs, ui.rs]
2026-07-11 Simplify ESP32 dev environment usage
    The ESP32 dev environment now works without having to install the
    toolchain manually and without dynamic linking.
    - Update flakes
    - Add rust-analyzer to both dev environments
2026-07-24 Fix typo in host_tui
    [event.rs]
2026-08-07 Small improvements
    - Made linear_regression output values that are directly usable in the
    spincoater
    - Recalibrated spincoater. The spincoater was tested to run at 8000
    plate RPM with about 40 RPM error.
    - Fix host_tui not writing all the data to the CSV
    - Fix sign of RPM error being flipped
    [constant.csv, increasing.csv]
2026-08-07 Temporary fix for GPIO bug
    [encoder.rs, main.rs, mod.rs, motion_profile.rs]
2026-08-12 Fix motor data file not opening for single RPMs
    [mod.rs]
2026-08-13 Replace linear model with cubic model
    This should reduce the overshoot and undershoot at various RPMs.
    - Fix DutyCycle documentation
    - Fix DutyCycle not clamping to at least STOP_DUTY
    [mod.rs, motion_profile.rs, pwm.rs]
2026-08-26 Minor time fixes
    - Fix runner loops slowly falling out of schedule
    - Deduplicate calls to Instant::now
    [encoder.rs, mod.rs, motion_profile.rs]
2026-08-27 Apply fixes for Clippy nursery lints
    [encoder.rs, mod.rs, motion_profile.rs, pid.rs, uart.rs, ui.rs]
2026-09-12 Update Rust version and dependencies
    - Remove the old method of detecting the motor interrupt because it no
    longer works
2026-09-12 Tune intercept for low RPM values (2000-3000 RPM)
2026-09-20 Small fixes
    - Initialize heap allocator in pin_usage_checker to avoid `cargo check`
    error
    - Remove `unreachable` checks on `Infallible` results
    - Remove outdated comment
    [encoder.rs, main.rs]
2026-09-30 Add integral term to feedback controller
    This should eliminate steady state error.
    The feedback controller now operates on f32s to avoid accumulating
    integer multiplication error.
    - Improve comment on strict division
    - Avoid immediately casting feedforward output to a float
    - Inline feedforward function which is only used once
    [encoder.rs, lib.rs, mod.rs, motion_profile.rs, pid.rs, pwm.rs]
2026-10-04 Add derivative term to feedback controller
    The plate RPM error is now extremely low (4 RPM when running at a single
    RPM).
    [lib.rs, mod.rs, motion_profile.rs, pid.rs]
2026-10-04 Small documentation fixes and performance improvements
    - Removed reference to postcard_rpc
    - Removed references to old interrupt method
    - Perform usize division instead of u64 division
    [encoder.rs]
2026-10-12 Reorganize repo into code, hardware, docs, data and images
    - Move rust/ to code/rust/ (no changes inside)
    - Remove the Arduino and MicroPython code (kept on the legacy branch)
    - Add READMEs, CONTRIBUTING (branch, tag and release flow) and docs guides
    - Add V34 R1 STEP exports, an approximate BoM, build photos, diagrams and
    the Aug vs Oct speed control comparison data
    - Mark V3 content as in progress, with TODOs to fill in
2026-10-14 Switch to external pull up for encoder pin
2026-10-18 Complete some TODOs
    - Switch from motor RPM to plate RPM in motion profile CSV files
    - Place commit hashes in the 2026-10-09 controller comparison
    - Create calibration guide
2026-10-20 Improve arithmetic
    - Avoid possible overflow when calculating average RPM
    - Report arithmetic errors when they occur
    - Improve rounding and clamping in DutyCycle
2026-10-20 Defer to rust and esp32 READMEs for setup guides
2026-10-21 Improve tests based on the used wire format
2026-10-25 Improve resiliency to RPM spikes
    - Significantly reduce rolling average window size. This decreases
    errors due to RPM spikes at the cost of exposing feedforward and
    feedback to more RPM jitter.
    - Readjust PID gains for the new rolling average window size
2026-11-03 Decrease P gain
    It caused large overshoot at 500 RPM.
    Unfortunately, this means we now have slight overshoot at all RPMs.
    This cannot be fixed with a D gain because the RPM jitter causes the D output to make the system less stable.
2026-11-04 Get time as soon as encoder interrupt fires
    This prevents the runner from messing with RPM calculation by accessing the mutex.
